yanbw-prog/finger-piano-fpga/docs/传感器设计计算.md

# 查阅资料与设计计算

## 任务书依据

- 传感器电路输出≤0.5 V；FPGA数字采集输入0～3 V。
- XC3S50AN的I/O电源为3.3 V；任务书给出VIH≥2.31 V、VIL≤0.99 V。
- 2 MHz分频生成C大调1～7，基础指标频率误差≤5%。
- LM386放大矩形波并推动喇叭。
- 验收包括单路0/1、3路0/1、分频和整体验收。

## 三传感器编码

| 编码 | 功能 | 编码 | 功能 |
|---|---|---|---|
| 000 | 静音 | 100 | 4，349.23 Hz |
| 001 | 1，261.63 Hz | 101 | 5，392.00 Hz |
| 010 | 2，293.66 Hz | 110 | 6，440.00 Hz |
| 011 | 3，329.63 Hz | 111 | 7，493.88 Hz |

## 模拟电路计算

每路FSR分压：

传感器输出电压 VS＝5 V × 4.7 kΩ ÷（RFSR＋RP＋4.7 kΩ）

通过100 kΩ电位器将正常按压调到0.40～0.45 V，最强按压≤0.5 V。

TL084每路采用非反相放大：

电压增益 Av＝1＋1 MΩ ÷ 200 kΩ＝6

正常按压后输出2.40～2.70 V，最大3.0 V。

RC低通滤波：

截止频率 fc＝1 ÷（2π × 4.7 kΩ × 100 nF）≈339 Hz

时间常数 τ＝4.7 kΩ × 100 nF＝0.47 ms

## 分频计算

半周期计数值 N＝四舍五入【2,000,000 ÷（2 × 音阶标准频率）】

实际输出频率＝2,000,000 ÷（2 × N）

| 音阶 | N | 实际频率 | 误差 |
|---:|---:|---:|---:|
| 1 | 3822 | 261.6431 Hz | +0.0050% |
| 2 | 3405 | 293.6858 Hz | +0.0088% |
| 3 | 3034 | 329.5979 Hz | -0.0097% |
| 4 | 2863 | 349.2840 Hz | +0.0155% |
| 5 | 2551 | 392.0031 Hz | +0.0008% |
| 6 | 2273 | 439.9472 Hz | -0.0120% |
| 7 | 2025 | 493.8272 Hz | -0.0107% |

## 器件资料要点

- TL084：四运放，使用±5 V供电；U1A/U1B/U1C处理三路信号。
- LM386：1、8脚开路时增益20；5脚必须经220～470 µF电解后接喇叭。
- FSR：受力增大时阻值减小，需现场标定三路电位器。

## 参考资料

1. 《手指钢琴》课程设计任务书。
2. TI TL084数据手册：https://www.ti.com/lit/ds/symlink/tl084.pdf
3. TI LM386数据手册：https://www.ti.com/lit/ds/symlink/lm386.pdf
4. AMD/Xilinx Spartan-3AN DS557：https://docs.amd.com/v/u/en-US/ds557
5. Interlink FSR Integration Guide：https://www.interlinkelectronics.com/integration-guides
