yanbw-prog/finger-piano-fpga/docs/预习报告.md

# 电工电子课程设计预习报告——手指钢琴

> 姓名：__________　学号：__________　班级：__________　日期：__________

## 1. 设计目的

利用三个柔性薄膜压力传感器得到三路 0/1 信号，形成3位二进制编码。000表示静音，001～111对应 C 大调1～7。XC3S50AN FPGA 对2 MHz时钟分频产生方波音频，由LM386放大后驱动喇叭。

## 2. 任务指标

1. 传感器电路输出不高于 0.5 V。
2. FPGA 数字采集端电压为 0～3 V，不得输入负压或 5 V。
3. 功放输入为矩形波。
4. 基础要求为音阶频率误差不超过 5%。
5. 完成乐句：11 55 66 5—｜44 33 22 1—。

## 3. 总体方案

适合在预习报告纸上临摹的最新总图见 [01_三传感器编码总电路图.svg](./01_三传感器编码总电路图.svg)。

三传感器编码手指钢琴总电路图

由于数字部分使用Verilog设计，坐标纸正面应画出ISE生成的顶层RTL模块，参考 [02_数字部分RTL图.svg](./02_数字部分RTL图.svg)。按老师最新要求，只画顶层方框和其输入输出端口，不展开内部逻辑。

XC3S50AN数字部分RTL图

每人使用三个压力传感器。每个传感器各经一路分压、TL084放大、RC滤波和限流后接入FPGA，三路状态直接形成音阶编码，不再使用七个板载键。

三个FSR→三路分压/放大/滤波→三路0/1采集→二进制编码→分频→LM386→喇叭

## 4. 模拟采集电路

三路完整接法见 [01_三传感器编码总电路图.svg](./01_三传感器编码总电路图.svg)。

### 4.1 传感器分压

三路通道结构相同。FSR1～FSR3各与一只100 kΩ电位器串联，取样点各通过4.7 kΩ接地：

传感器输出电压 VS＝5 V × 4.7 kΩ ÷（RFSR＋RP＋4.7 kΩ）

调试时先把电位器调到最大阻值，然后在“正常有力按压”状态下缓慢调整，使测试点 TP1 为 0.40～0.45 V，且最用力按压时仍不超过 0.5 V。电位器滑动端应与所使用的固定端短接，避免滑片偶然开路。

### 4.2 TL084 放大

U1A、U1B、U1C分别放大三路信号。每路使用反馈电阻 Rf＝1 MΩ 和接地电阻 Rg＝200 kΩ，理论增益均为：

电压增益 Av＝1＋Rf ÷ Rg＝1＋1 MΩ ÷ 200 kΩ＝6

每路正常按压时的分压输出均调为0.40～0.45 V，放大后为2.40～2.70 V；最强按压不超过0.5 V，放大后不超过3.0 V。TL084使用±5 V供电。

### 4.3 低通滤波和 FPGA 限流接口

TP2 经 4.7 kΩ 串联电阻和 100 nF 对地电容构成一阶低通：

时间常数 τ＝R × C＝4.7 kΩ × 100 nF＝0.47 ms

截止频率 fc＝1 ÷（2πRC）≈339 Hz

该滤波能抑制接触尖峰，不会明显拖慢手指动作。TP3 与 FPGA 之间串联清单中的 100 kΩ 电阻，作为误接或短时过压时的限流电阻。本方案不另外使用钳位二极管，因此接 FPGA 前必须用万用表或示波器确认 TP3 在所有按压状态下均处于 0～3.0 V。

## 5. FPGA 音频分频设计

选择 C4～B4 为 1～7。方波每经过 N 个时钟翻转一次：

半周期计数值 N＝四舍五入【fclk ÷（2 × fnote）】

实际输出频率 fout＝fclk ÷（2 × N）

| 唱名 | 音名 | 标准频率/Hz | 半周期计数 N | 实际频率/Hz | 误差 |
|---:|:---:|---:|---:|---:|---:|
| 1 | C4 | 261.63 | 3822 | 261.6431 | +0.0050% |
| 2 | D4 | 293.66 | 3405 | 293.6858 | +0.0088% |
| 3 | E4 | 329.63 | 3034 | 329.5979 | -0.0097% |
| 4 | F4 | 349.23 | 2863 | 349.2840 | +0.0155% |
| 5 | G4 | 392.00 | 2551 | 392.0031 | +0.0008% |
| 6 | A4 | 440.00 | 2273 | 439.9472 | -0.0120% |
| 7 | B4 | 493.88 | 2025 | 493.8272 | -0.0107% |

最大误差约 0.016%，明显优于 5% 指标。

Verilog 源码见 [finger_piano.v](./Verilog源码/finger_piano.v)，仿真文件见 [tb_finger_piano.v](./Verilog源码/tb_finger_piano.v)。三路传感器分别经两级同步和10 ms数字消抖，稳定后的3位状态直接作为音阶编码。

## 6. LM386 音频功放

功放部分已画在总电路图右侧。FPGA `audio_out` 经 100 nF 隔直电容和 100 kΩ 音量电位器送入 LM386 3 脚，2 脚接地。1、8 脚开路时电压增益为 20。

LM386 5 脚具有直流偏置，必须通过 220～470 µF 电解电容后再接喇叭；电解电容正极接 5 脚，负极接喇叭。这是本方案唯一必须额外准备的非电阻元件。6 脚供电处使用清单中的 100 nF 去耦；1、8 脚和 7 脚均保持开路，不增加其他电容。

## 7. 面包板落地布线

图中实验箱电源接线柱的字样不清晰，不可只凭端子颜色判断极性。上电前必须用万用表确认 +5 V、0 V、-5 V，然后贴标签。所有模块必须共地：实验箱 0 V、FPGA GND、TL084 的信号地、LM386 4 脚均相连。

推荐将大面包板由左到右划分为：

面包板上将三路传感器调理电路并排放置，三路输出线并行引向FPGA；实际孔位以现场面包板连通性测量为准。

1. 左侧：FSR1～FSR3、P1～P3及三路取样电阻。
2. 中左：TL084的U1A/U1B/U1C、三组增益电阻和三路RC滤波。
3. 中右：FPGA 输入限流电阻与 FPGA 排线。
4. 右侧：LM386、音量电位器、大电解和喇叭。

模拟小信号线与喇叭大电流线分开；LM386 到喇叭的连线要短；电源轨若在面包板中间断开，需用跳线桥接。面包板每个五孔组内部相通，芯片必须横跨中央隔槽。

### 芯片引脚接线表

| 器件引脚 | 接法 |
|---|---|
| TL084-4 | +5 V |
| TL084-11 | -5 V |
| TL084-3 | TP1，U1A 同相输入 |
| TL084-2 | U1A 反相输入；同时通过 200 kΩ 接地 |
| TL084-1 | 第1路输出；通过 1 MΩ 反馈到 2 脚 |
| TL084-5、6、7 | 第2路：5脚同相输入，6脚反相输入，7脚输出 |
| TL084-10、9、8 | 第3路：10脚同相输入，9脚反相输入，8脚输出 |
| TL084-12、13、14 | 未用U1D：12脚接0 V，13脚与14脚相连 |
| LM386-1、8 | 开路（增益 20） |
| LM386-2、4 | 0 V |
| LM386-3 | 音量电位器滑动端 |
| LM386-5 | 220～470 µF 正极；电容负极接喇叭 |
| LM386-6 | +5 V |
| LM386-7 | 开路（基础电路不使用旁路电容） |

## 8. 调试与验收步骤

1. **断电检查**：确认芯片方向、电解极性和电源轨无短路。
2. **只接电源**：不插芯片，测各座的电源脚；确认无误再断电插芯片。
3. **验收传感器**：分别测三路取样点TP1～TP3，逐只调整P1～P3，正常按压为0.40～0.45 V，最强按压不超过0.5 V。
4. **验收放大滤波**：分别测三路RC滤波输出，正常按压约2.4～2.7 V，最强按压不超过3.0 V，松开时低于0.8 V。
5. **验收 FPGA**：暂不接LM386，依次输入001～111七种手指组合，用LED核对编码，用示波器核对 `audio_out` 频率。
6. **验收功放**：音量调到最小后接入 LM386，再缓慢增大。
7. **整体验收**：演奏指定乐句，记录七个实测频率。

## 9. 清单器件实际用量

| 器件 | 本方案用量 | 用途 |
|---|---:|---|
| TL084 | 1片 | U1A、U1B、U1C处理三路传感器，U1D闲置处理 |
| LM386 | 1片 | 喇叭功率放大 |
| 2 MHz有源晶振 | 1只 | FPGA分频时钟 |
| 100 kΩ电位器 | 4只/清单有4只 | 三路FSR灵敏度及一路音量 |
| 100 nF电容 | 6只/清单有6只 | 三路RC滤波、TL084去耦、LM386输入隔直和供电去耦 |
| 4.7 kΩ电阻 | 6只/清单有10只 | 三路FSR取样及三路RC滤波 |
| 1 MΩ电阻 | 3只/清单有3只 | 三路TL084反馈 |
| 200 kΩ电阻 | 3只/清单有6只 | 三路TL084增益设定 |
| 100 kΩ电阻 | 3只/清单有6只 | 三路FPGA输入限流 |
| 1/8 W喇叭 | 1只 | 声音输出 |
| 柔性压力传感器 | 每人3只 | 三位二进制按压编码 |

未使用 DAC0808 和 ADC0804，因为基础指标只要求 0/1 采集和方波音频；将它们加入反而增加布线与调试量。

## 10. 最小自备器件

| 器件 | 建议值 | 数量 | 用途 |
|---|---:|---:|---|
| 电解电容 | 220～470 µF / ≥10 V | 1 | LM386 输出隔直，普通低阻喇叭必需 |

除这只电解电容外，基础指标电路不要求自备其他非电阻元件。如果实验室能提供该电容，则不需自备任何非电阻元件。

## 11. 预期问题与对策

- **不按也响**：降低传感器分压或增大数字消抖时间；检查 TP3 松开时是否低于 FPGA 低电平上限。
- **按下不响**：检查 TP1 是否随压力上升，然后逐级检查 TP2、TP3。
- **喇叭啸叫**：缩短 LM386 布线，加大供电去耦，分开输入线和喇叭线，不在 1、8 脚加增益电容。
- **FPGA 输入异常**：立即断电，确认模拟地与 FPGA 地已共地，检查 TL084 的 1 MΩ/200 kΩ 反馈网络和 100 kΩ 限流电阻，确保 TP3 不超过 3.0 V。

## 12. 参考资料

1. Texas Instruments, [TL08xx FET-Input Operational Amplifiers Data Sheet](https://www.ti.com/lit/ds/symlink/tl084.pdf)：TL084 引脚、供电范围、输入共模范围与输出摆幅。
2. Texas Instruments, [LM386 Low Voltage Audio Power Amplifier Data Sheet](https://www.ti.com/lit/ds/symlink/lm386.pdf)：增益 20～200、基本应用电路、输出隔直与去耦。
3. AMD/Xilinx, [Spartan-3AN FPGA Family Data Sheet DS557](https://docs.amd.com/v/u/en-US/ds557)：XC3S50AN 器件概述、I/O 与电气特性。
4. Interlink Electronics, [FSR 400 Series Integration Guide](https://www.interlinkelectronics.com/integration-guides)：柔性压力传感器的力—电阻特性及分压接法。
5. 《手指钢琴》课程设计任务书（教师提供）。

## 13. 结论

该方案使用三个FSR完成三路压力0/1采集，通过3位二进制状态实现七音编码，与更新后的元件发放方案和“3路0/1采样”验收要求相符。分频计算的最大理论频率误差小于0.02%。
