yanbw-prog/finger-piano-fpga/docs/验收三基本指标调测单.md

# 手指钢琴课设——验收三（基本指标）调测单

姓名：______________　学号：______________　日期：______________

本单对应黑板左侧“验收三：基本指标”。验收内容为：

1. 测量三路传感器送入 FPGA 的输入端电压，分别记录“按下”和“不按”；
2. 说明并演示扬声器能够按传感器编码发声；
3. 填写是否继续扩展。

---

## 一、验收前的最终连接确认

### 1. 传感器与FPGA输入

三路模拟电路的最终输出 Uo 分别接入 FPGA。传感器为低电平有效：

| 传感器 | FPGA输入管脚 | 按下时预期 | 不按时预期 |
|---|---|---|---|
| 传感器1（A） | P76 | 低电平，约0～0.25 V | 高电平，约2.75～3.25 V |
| 传感器2（B） | P77 | 低电平，约0～0.25 V | 高电平，约2.75～3.25 V |
| 传感器3（C） | P78 | 低电平，约0～0.25 V | 高电平，约2.75～3.25 V |

三路输出、FPGA GND、模拟电路 GND 必须共地。输入不得接入 +5 V 或 −5 V。

### 2. 扬声器功放

烧录今天验收二已经使用的程序；该程序中的 `audio_out` 已在 UCF 中约束到 **P90**。

```text
FPGA P90 → 100 nF输入电容 → 100 kΩ电位器 → LM386 3脚

LM386 6脚 → +5 V；6脚经100 nF → GND
LM386 2脚、4脚 → GND
LM386 5脚 → 330 µF电解正极
330 µF电解负极 → 扬声器 → GND
LM386 1脚、7脚、8脚：悬空
```

注意：330 µF 电解电容的**正极在LM386 5脚一侧**；P90 不可直接接扬声器。

---

## 二、（1）FPGA输入端电压测量

### 1. 万用表连接方法

1. 万用表置直流电压档，量程选20 V或自动档。
2. 黑表笔始终夹在公共 **GND**。
3. 红表笔依次接到 P76、P77、P78 对应的实际输入节点。建议测“模拟输出线刚进入FPGA排针的点”，不要把表笔插入芯片脚之间，以免短路。
4. 不按任何传感器时，等待1秒后记录三路“不按”电压。
5. 每次只按下一只传感器，保持按住1秒后记录该路“按下”电压；再松开，继续下一路。

### 2. 填写表格

| 传感器 | FPGA输入端 | 按下电压（V） | 不按电压（V） | 判定 |
|---|---|---:|---:|---|
| 传感器1（A） | P76 | ________ | ________ | □合格 □待调 |
| 传感器2（B） | P77 | ________ | ________ | □合格 □待调 |
| 传感器3（C） | P78 | ________ | ________ | □合格 □待调 |

判定原则：按下为低电平、松开为高电平即可被FPGA稳定识别。按下若高于约0.8 V，或不按低于约2.0 V，先检查该路模拟电路、公共地和接线，不要直接送入FPGA。

---

## 三、（2）扬声器工作演示

### 1. 上电顺序

1. 电位器先调到最小音量。
2. 接通模拟电路、FPGA和LM386的+5 V；确认LM386的6脚对GND约为+5 V，芯片不发烫。
3. 用示波器确认 FPGA **P90** 有约0～3.3 V方波输出。
4. 缓慢调大电位器音量，按传感器组合，扬声器应发出相应音高。

### 2. 演示编码

程序编码顺序为 Verilog 中的 `{A, B, C}`，本电路对应 `A=P76，B=P77，C=P78`。传感器按下为0，不按为1。

| 输入状态 | 预期音符 | 标准频率（Hz） | 扬声器是否听到 |
|---|---|---:|---|
| 000 | B4 | 493.83 | □是 □否 |
| 001 | A4 | 440.00 | □是 □否 |
| 010 | G4 | 392.00 | □是 □否 |
| 011 | F4 | 349.23 | □是 □否 |
| 100 | E4 | 329.63 | □是 □否 |
| 101 | D4 | 293.67 | □是 □否 |
| 110 | C4 | 261.62 | □是 □否 |
| 111 | 静音 | — | □静音正常 □异常 |

验收时至少演示两个明显不同的音符（例如000的B4、110的C4），再演示111静音。若老师要求，可完整演示七个音符。

### 3. 喇叭工作结论

```text
喇叭工作（  √  /  ×  ）
```

### 4. 信号频率的测量和填写

黑板上的“信号频率（　）”填写的是FPGA音频输出 **P90** 的实际测量频率，不是2 MHz晶振频率。建议验收时选择输入`000`，此时扬声器发B4音，标准频率约为493.83 Hz。

示波器连接和设置：

```text
探头尖端 → FPGA P90
地夹     → FPGA GND

CH1、DC耦合、×10探头
垂直：1 V/div；水平：1 ms/div
触发：CH1、上升沿、触发电平约1.5 V
菜单：Measure → Frequency → CH1
```

例如示波器读数为493.8 Hz，验收栏填写：

```text
喇叭工作（√）
信号频率（493.8 Hz）
```

若选择其他编码，则填写相应实测值：`001`约440.0 Hz，`010`约392.0 Hz，`110`约261.6 Hz。输入`111`时为静音，频率可写“0 Hz（静音）”或“无”。

若无声，按以下顺序排查：

1. P90是否仍有方波；
2. LM386 6脚是否为+5 V；
3. FPGA、LM386、模拟电路是否共地；
4. 330 µF极性是否“5脚为正极”；
5. 电位器中间脚是否到LM386 3脚、音量是否开得过小；
6. 扬声器是否接在“电容负极—扬声器—GND”路径中。

---

## 四、（3）是否继续扩展

```text
是否继续扩展（  √  /  ×  ）
```

本次验收三的最低要求是三路输入电平正确、扬声器可随编码发声并可静音。若选择继续扩展，可在此基础上增加更多传感器、增加曲目自动演奏或改善音色；扩展前先保留本次能正常工作的接线和烧录文件。

---

## 五、给老师的简短说明

“三路柔性压力传感器经模拟调理后输出低/高电平，分别送入FPGA的P76、P77、P78，对应程序输入A、B、C。FPGA根据三位编码用2 MHz时钟分频生成对应音符方波，音频信号由P90输出。P90经过100 nF隔直、电位器调节和LM386功放后驱动扬声器。三路不按时为111，系统静音。”
