yanbw-prog/finger-piano-fpga/docs/面包板搭建与调试.md

# 面包板搭建与调试

## 搭建顺序

1. 用万用表确认实验箱+5 V、0 V、-5 V，不按接线柱颜色猜测。
2. 并排搭建fSR1～FSR3的三路分压电路。
3. TL084横跨面包板中央隔槽，4脚接+5 V，11脚接-5 V。
4. 搭建u1A/U1B/U1C三路增益6的放大器及三路RC滤波。
5. 三路输出检查合格后，通过100 kΩ限流电阻接FPGA，并与FPGA共地。
6. 最后搭LM386，音量调到最小后上电。

## 测量标准

| 位置 | 松开 | 正常按压 | 上限 |
|---|---:|---:|---:|
| FSR分压输出 | 尽量<0.165 V | 0.40～0.45 V | 0.5 V |
| TL084/滤波输出 | <0.99 V | 2.40～2.70 V | 3.0 V |
| `audio_out` | 0 V | 0/3.3 V方波 | 3.3 V |

## 验收顺序

1. 单路0/1采样。
2. 3路0/1采样。
3. LED检查编码000～111。
4. 示波器测量七个分频。
5. 接入LM386和喇叭，演奏`11 55 66 5- | 44 33 22 1-`。

## 安全要求

- FPGA不得输入负压或5 V。
- LM386第5脚经220～470 µF电解后再接喇叭，电容正极接LM386。
- 任何改线都要先断电；喇叭线与传感器小信号线分开。
