yanbw-prog/finger-piano-fpga/(commit log)

2026-09-24 feat: add FPGA pin constraints
2026-09-24 docs: add sensor conditioning schematic
2026-09-24 docs: add LM386 amplifier schematic
2026-09-24 docs: replace with complete three-channel system schematic
2026-09-24 fix: align third sensor channel with FPGA input
2026-09-27 docs: add final top-level RTL schematic
